DML-0205Michael/Brushless-Self-Balance-Bot-FOC/stl/25_led_cover.stl

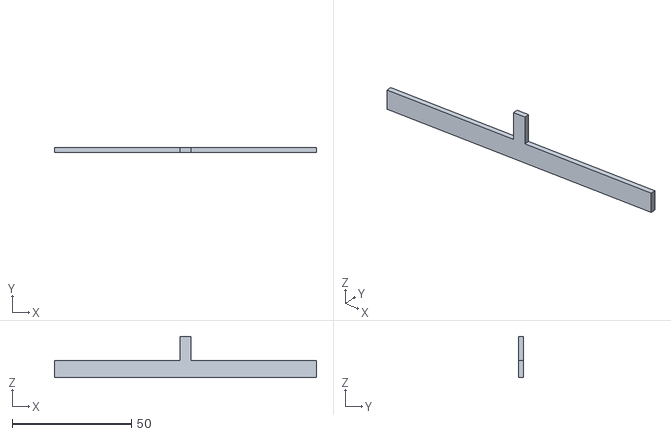
[picture p1: CAD file, 2024-08-12]
stl/25_led_cover.stl
109.8 x 2.00 x 17.4
