DML-0205Michael/Brushless-Self-Balance-Bot-FOC/stl/24_breadboard_holder.stl

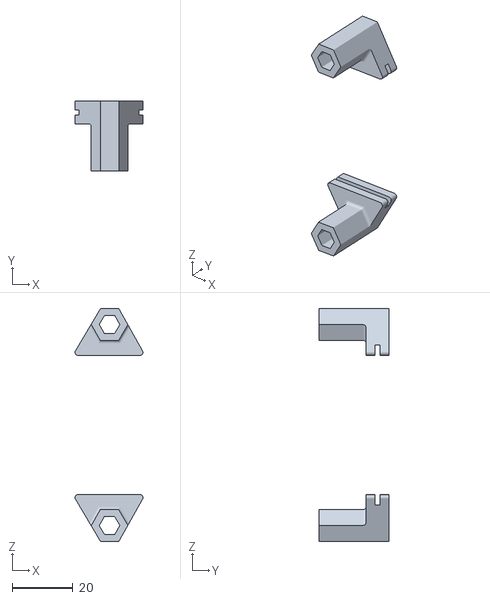
[picture p2: CAD file, 2024-08-12]
stl/24_breadboard_holder.stl
22.4 x 23.0 x 77.0
