DML-0205Michael/Brushless-Self-Balance-Bot-FOC/stl/03_wheel_hub.stl

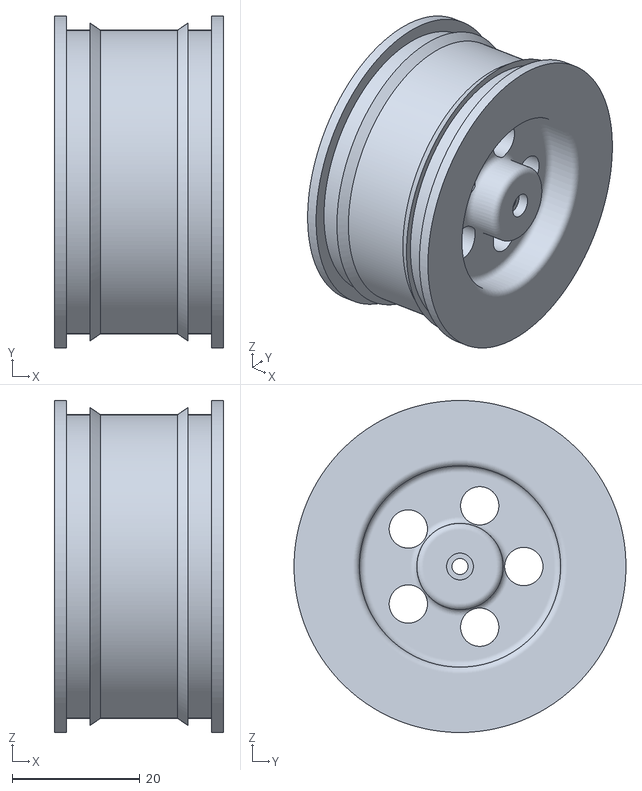
[picture p3: CAD file, 2024-08-12]
stl/03_wheel_hub.stl
26.5 x 52.0 x 52.0
