DML-0205Michael/Brushless-Self-Balance-Bot-FOC/stl/balance bot FOC.3mf

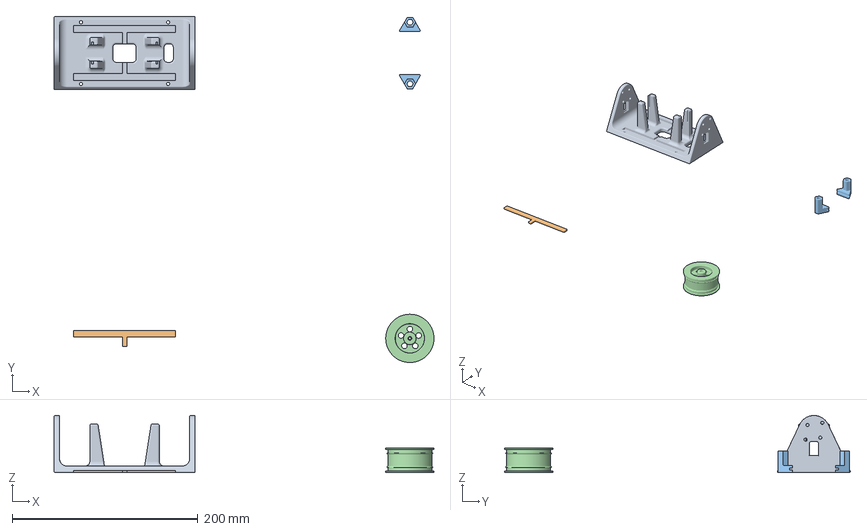
[picture p4: CAD file, 2024-08-12]
stl/balance bot FOC.3mf
409.2 x 372.6 x 61.4 mm
07_chassis.stl
25_led_cover.stl
24_breadboard_holder.stl
03_wheel_hub.stl
