DML-0205Michael/Brushless-Self-Balance-Bot-FOC/stl/07_chassis.stl

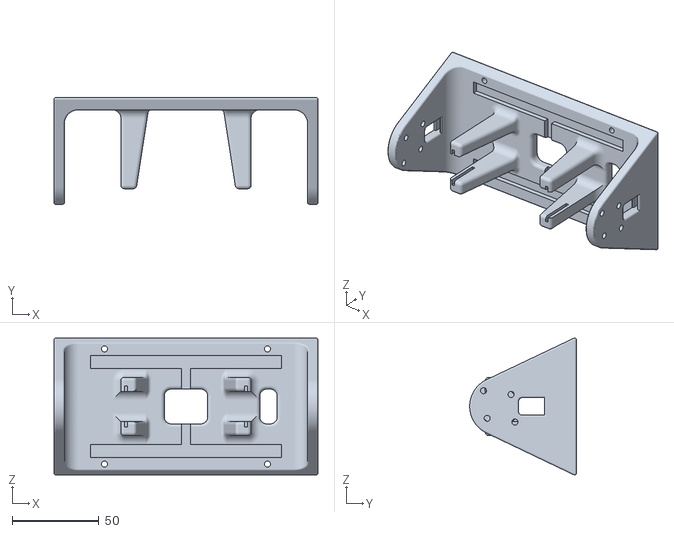
[picture p5: CAD file, 2024-08-12]
stl/07_chassis.stl
152.0 x 61.4 x 78.8
