DML-0205Michael/Brushless-Self-Balance-Bot-FOC/build.pdf

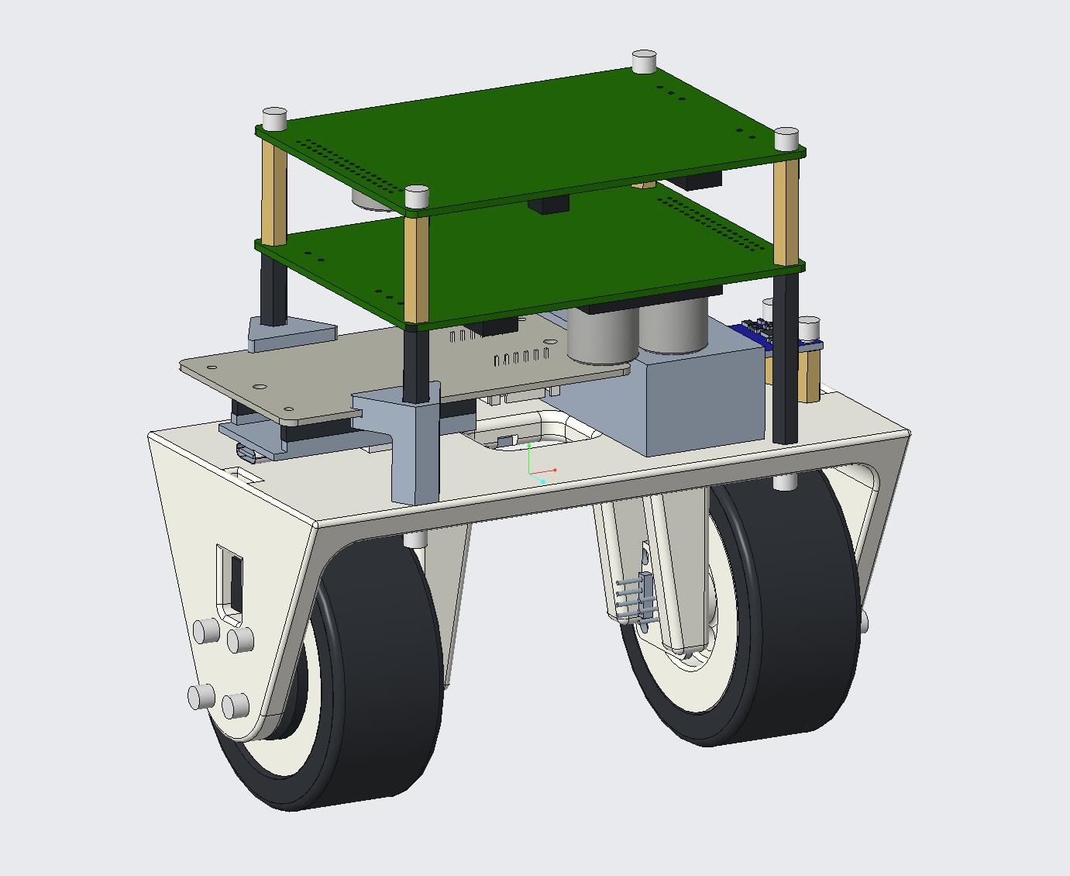
[picture p6: page 1]
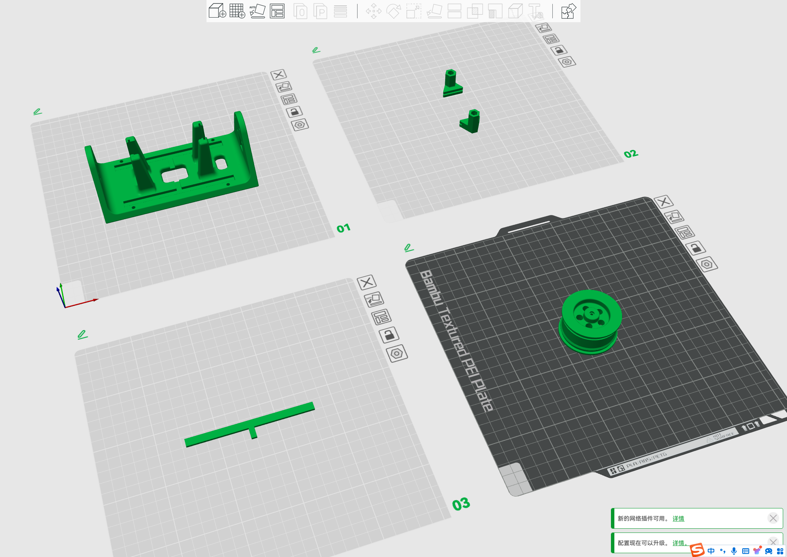
[picture p7: page 2]
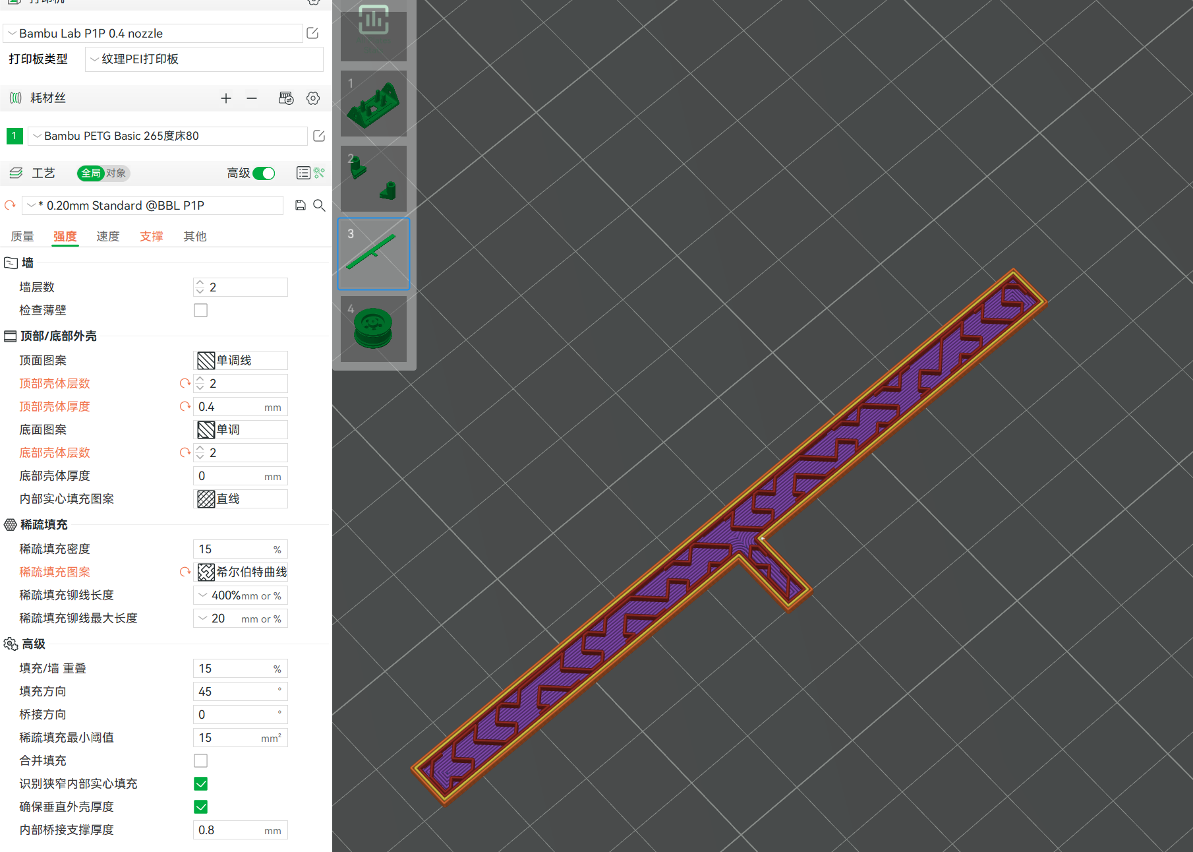
[picture p8: page 3]
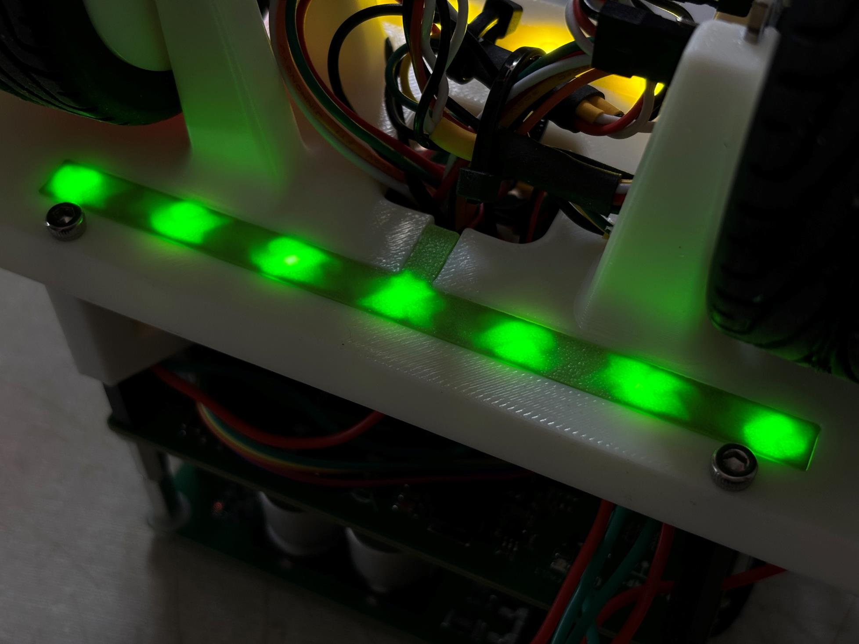
[picture p9: page 4]
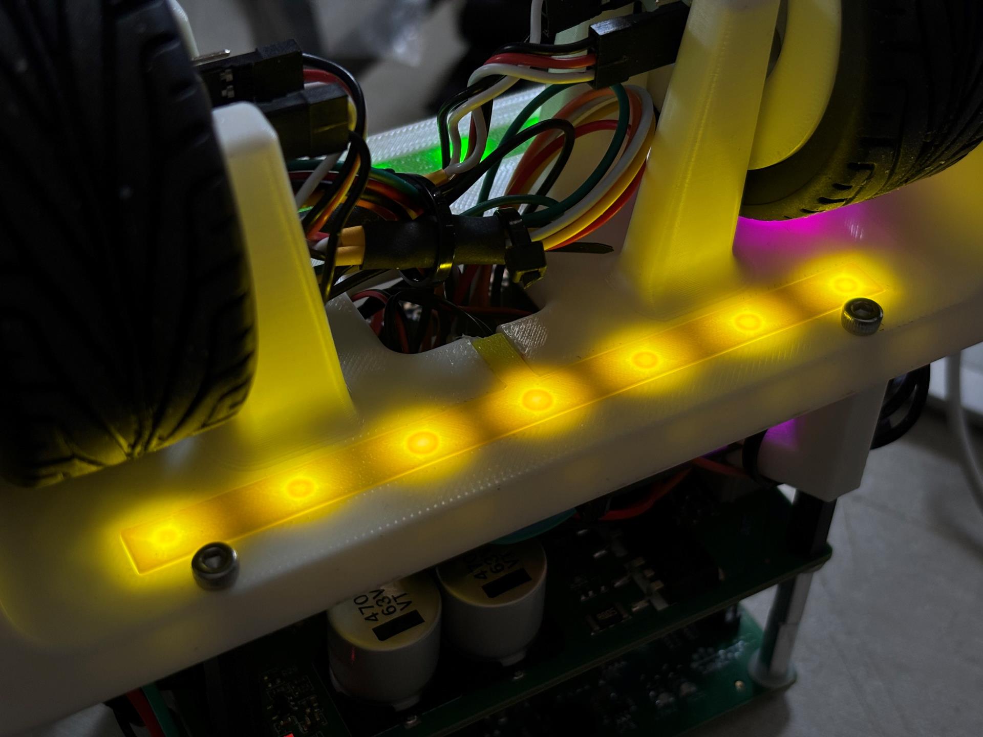
[picture p10: page 5]
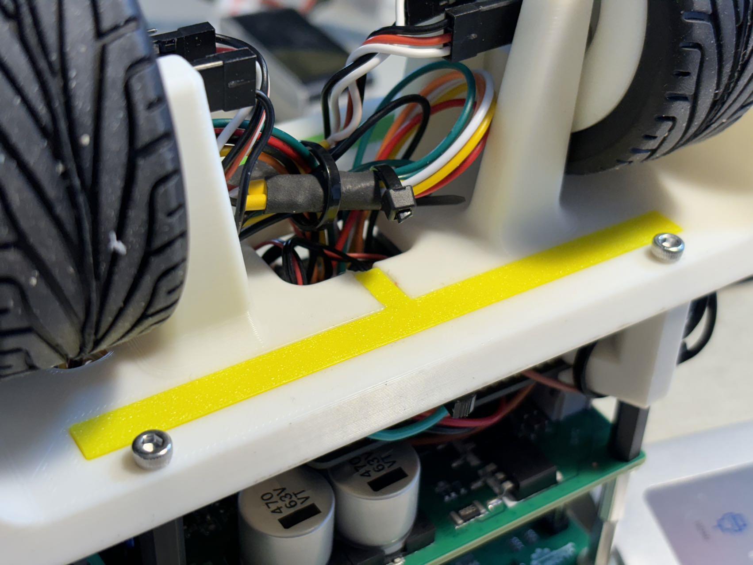
[picture p11: page 6]
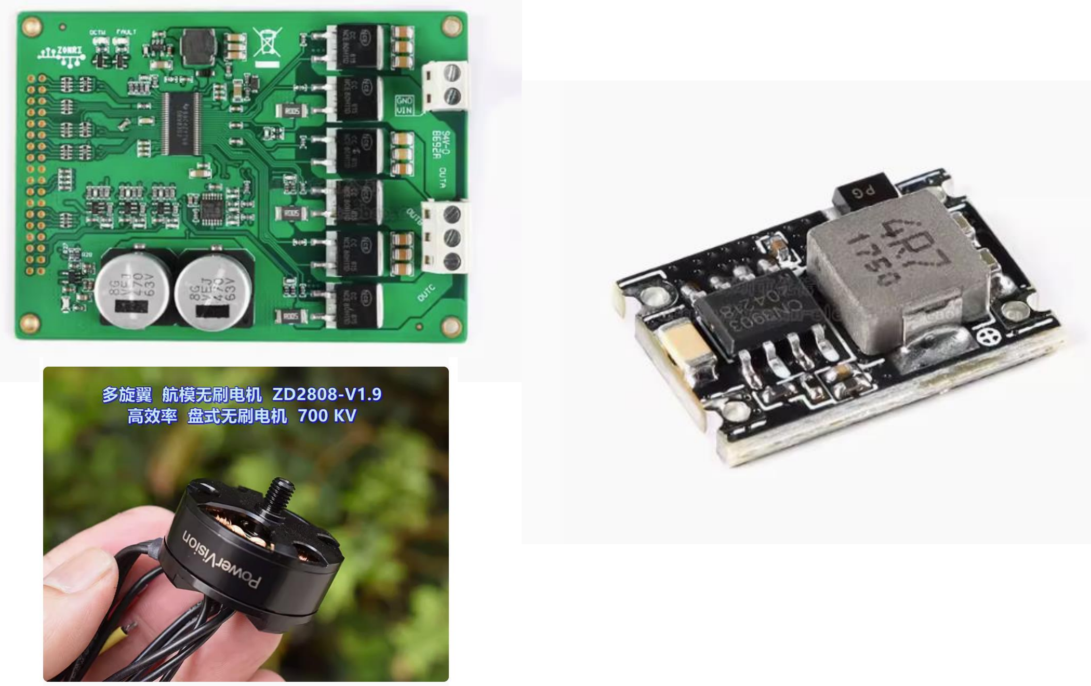
[picture p12: page 7]
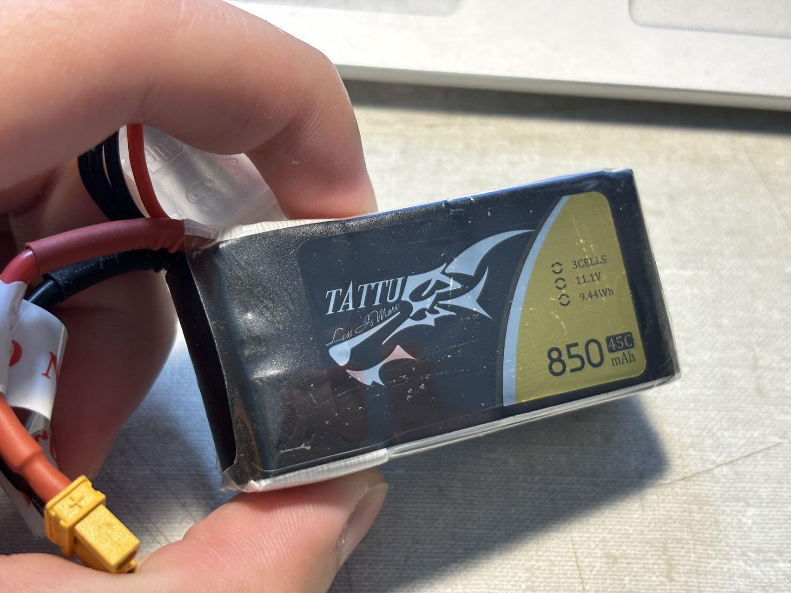
[picture p13: page 8]
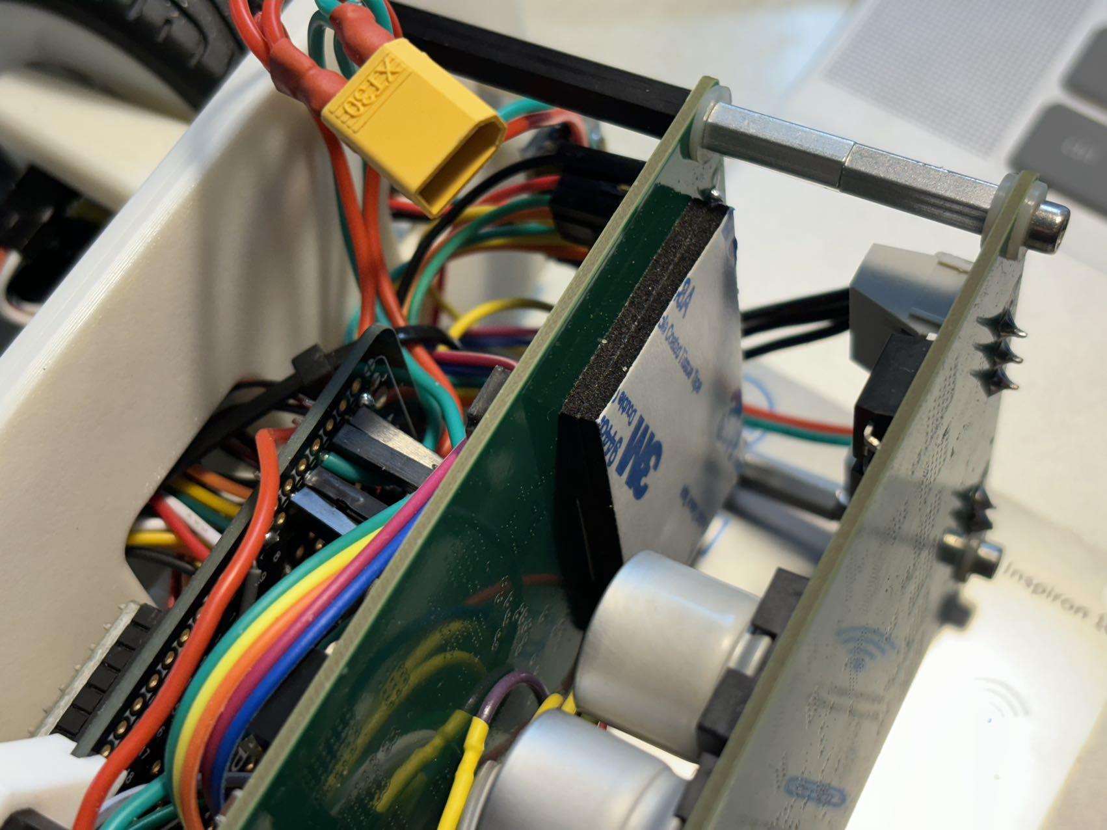
[picture p14: page 9]

参考链接
Reference:

https://docs.simplefoc.com/drv8302_examplehttps://www.ti.com/lit/ds/symlink/drv8302.pdf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 F%252Fwww.mouser.com%252F (https://www.ti.com/lit/ds/symlink/drv8302.pdf?ts=1723239724335)
http://dengfoc.com/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 %9F%E5%BA%A6%E4%BB%A3%E7%A0%81%E7%9A%84%E6%92%B0%E5%86%99 (http://dengfoc.com/)
