DML-0205Michael/Brushless-Self-Balance-Bot-FOC/Vb measure.xlsx

x | Vb
905 | 10.1
943 | 10.45
972 | 10.77
995 | 10.95
1037 | 11.3
1071 | 11.62
1097 | 11.89
1115 | 12.09
1141 | 12.31
1157 | 12.43
1173 | 12.61
1194 | 12.78
1221 | 13.02
1200 | 12.87
1173 | 12.64
1159 | 12.48
1140 | 12.29
1113 | 12.03
1082 | 11.73
1056 | 11.5
1023 | 11.2
993 | 10.94
965 | 10.68
939 | 10.42
912 | 10.16
