DML-0205Michael/Brushless-Self-Balance-Bot-FOC/Schematic_Balance-Bot-FOC_2024-08-11.pdf

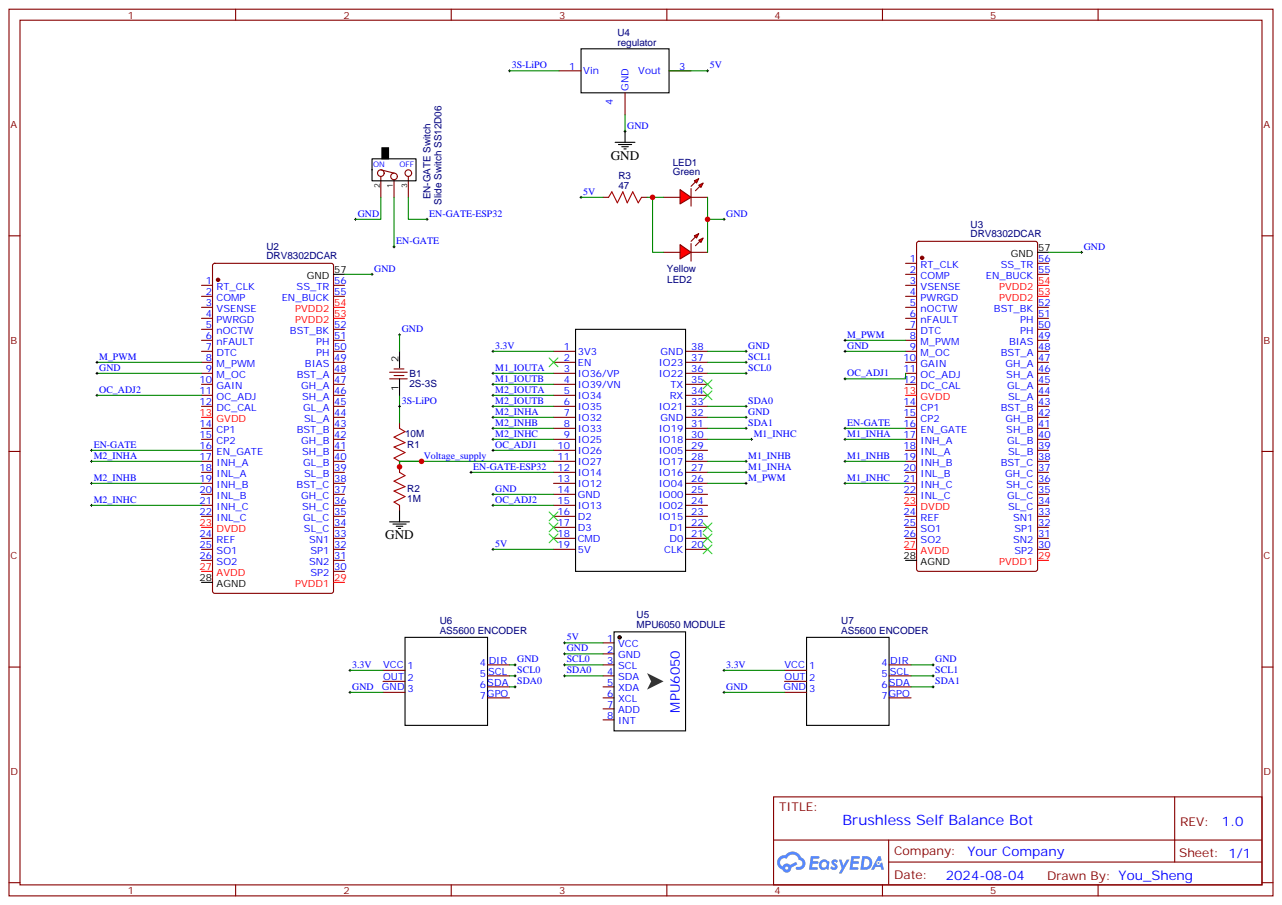
[picture p15: page 1]
